persfi/riscv-snn-accelerator/docs/LOG.md

# Engineering Log

## 2026-07-03
- Finished verilog essentials over the last week on HDLbits. (modules, gates, ffs & latches, ALUs, counters, shift registers)

## 2026-07-04
- Ordered Arty A7 100T (digikey tw). See D1 in DESIGN.md.
- Installed verilator, GTKwave (from apt not source / see D2 DESIGN.md), make, venv for snntorch, numpy, pytest, torch that'll be used later. Did not use Conda for managing packages as it only tracks Python packages, so it's unable to track verilator or toolchains etc that'll be needed in the project.
- cd to root of wsl from powershell can reset ubuntu's password directly (bypassing wsl).
- Editors track venv by the name .venv so named it .venv instead of any other names.
- Learned makefile basics. ( $(path shortcut) / .PHONY tells make that they are commands not files )
- tool_versions.md for all tool versions including and outside venv.
- Ubuntu apt update failed due to connection issue with ipv6 (new type of ip address), switched to ipv4 → works
- requirements.txt created with make freeze so python packages can be installed in the future in one command.
- pip install torch installs the whole stack including ones designated for gpus (which i don't have), uninstalled and installed --index-url .../whl/cpu saving space. 
- project originally created in mnt/c, figured operating it from wsl slows it down, tried mv them to wsl home. mv failed, files got deleted before git init → had to reinitialize the whole project (always git init first)

## 2026-07-05
- installed vivado 2026.1 version (needed for arty a7 100t see D1 DESIGN.md): stripped bare except for arty A7 and basic tools to save disk space. 2026 july version's license had an update → used basic tier node locked (tie to machine)
- dll error when launching vivado, installed visual c++ distributable for the missing 2015-2022 x64 thats causing the error → works.
- ethernet MAC for vivado host ID (don't have dongle flexid of enterprises, disk serial number more fragile to drive swaps)
- Vivado installed on windows as wsl doesnt have default usb port that'll be used for connecting my board.
- learn riscv assembly → till stacks.

## 2026-07-06
- installed 64 riscv toolchain from apt, quick and can still run 32 compile commands.
- smoke test with c file passed → toolchain works properly.
- studied RISC-V isa, RISC-V assembly, single cycle datapaths, control unit mapping table, and performance eval → can start writing rv32i's verilog tomorrow.
- add riscv tests as git submodule for testing later.

## 2026-07-07
- \+ verilog (&sv) extension in vscode.
- some datapath labels dont follow riscv naming → switched all of them to riscv to make it easier to cross check with encode/decode tables.
- write data with clk, read data continuosly so that instructions can be proccessed in a single cycle.
- ascending index range is the convention for arrays ex [0:31].
- wrote regfile.v (combinational read, x0 gated both sides, no reset)
- theres 32 registers bc in isa they define 5 bits for rs1 and rs2. 
- need to map truth tables for ALUs design from isa spec.
- added make lint → checked for errors for regfile → all fine
- enable inset final newline in vscode to prevent lint warnings of their absence
- harness written by claude, reviewed the functions → understood what each of them does so i can write tests properly(generate boilerplate but unit tests are mine to write)

## 2026-07-08
- in simulator testing, if assign an value, it does not update automatically like real silicons do(for continuous assignments). Have to call eval() to tell the simulatro to reevaluate (see regfile_tb.cpp).
- only the signals that appear in the port list get exposed as accessible fields on the generated Vregfile C++ class so internally declared signals cant be called with dut.
- call tb defined methods with tb and verilator defined objects with dut (tb.top)
- tried writing to rs1_data and check if it is correct after settle(), failed tests. Figured reason: I can only drive module input ports in test files. anything written to output ports will get discarded after eval().
- may be able to recieve the fpga board on 7/10
- regfile_tb 8/8 tests success. (vscode underlines import as errors because verilated.h is in /usr/share/verilator/include/verilated.h not in project repo. The file is included from makefile so there's actually no errors. → add the path to c_cpp_properties.json to remove the false red underline)
- use 4 bits for determining the type of operations in ALUs because rv32i uses funct3 (8 variations) and funct7[5] (1 bit, 2 variations) to set them apart. 8 < 10 variations <16(4bit) therefore uses 4 bits.
- weighed localparam or 'define for my constants file(defs.vh). Chose localparam because it's actually a constant while 'define is just a macro replacing texts(hard to debug if its duplicated, no type support and lint will not catch the error).
- built alu.v ran lint, failed → RTL_SOURCES only includes (.v) → added Irtl/core to search through core → lint suceeded

## 2026-07-09
- wrote alu_tb, all tests passed (29/29). As alu doesn't have clk, added a no-clk condition in tb_harness.
- because there's a vh file for alu in core, changed unit-test call to make sure it searches for vh's when they're encountered
- wrote vectors.s, got to actually memorize the commands and sytnaxs from building not reading (failed to assemble when I didn't put commas between operands and mixed in several '//'s)
- assmebly: label is just the name for the addr of the next instruction
- CC enforces testbench split settings in claude.md thats based on file type rather than actually test logic → amended claude.md
- lint warns unused bits for inst → not sure if I won't use those bits in the future → added local lint waiver at port → lint pass. Same for vh file, as alu params arent used → local waiver at include → lint pass. 
- imm_gen tb passed (14/14)

## 2026-07-10
- wrote pc rtl lint and tests (6/6) passed.
- wrote imem rtl lint and tests (6/6) passed.
- parameter N = \$clog2(DEPTH) in imem.v, $clog2 might be risky for quartus versions but it should be fine with vivado for now. change in the future if needed.
- $readmemh, default verilog system task, copies hex text file to memory array. 
- program.hex will need to load too many tests, and if harness fails to copy then it will be a hard to catch bug → considered plusarg but it only works for sim to read at runtime and not for synthesizers (no runtime concept) → used a pragma of verilator, created load hex in harness to handle write to mem for all sim tests, synth is unaffected as the pragma would be seen as comment and it will run instead.
- typhoon today, board not arriving. 
- no need for 0x in hex files. 
- no need to write assembly instructions for imem testing because it doesn't matter if the hex encoded from the instructions are correct, the function I'm testing for imem is if it reads hex file properly and truncates the index of addresses correctly.

## 2026-07-11
- harvard architecture: needed seperate imem and dmem. Built dmem without write, test (6/6) passed. finish all leaf files.
- error in assign in core file, then realized its not actually a problen with assign its forgetting to write the module name → always debug from the first occuring error.
- output signals can be read in modules→ never seen in hdlbits practice but apparently its common. 
- wrote core rtl for pc+imem wiring, testing passed (8/8).
- error when linked all leaf files in core, turns out its because of defs's define guard, when multiple modules that uses it are loaded into core, the preprocessing state of verilator remembers that macro was called before so it doesn't load again into the other leaf files. but each modules has their own scope and needs to include param independantly → remove the guard 
- define guard was C convention, to prevent duplicating parameters in the same translation unit(complete chunk of C or C++ code that the compiler processes in one compilation) if included twice. but modules have their own scope so it doesnt apply to verilog
- wrote lw path, lint and test (25/25 in total for core) passed.

## 2026-07-12
- wrote sw path, lint and test (31/31 in total for core) passed.
- don't put spaces around trace "=" or itll return a empty variable error
- upgraded harness and trace handling (via claude as it's more of a boilerplate) to make tb visualization cleaner and saves time writing tb. 
- r type path wires, lint and test (36/36 in total for core) passed.
- riscv64-unknown-elf-gcc only accepted 0-31 shamt, tried -4 but failed → changed to 4
- last rtype test left pc at 24, need a rst or it reads old instructions.
- wrote itype paths, lint and test (43/43 in total for core) passed.

## 2026-07-13
- fpga board arrived, connected via micro usb. power led fine, done led works, preprogramed led patterns work. Vivado device manager can also connect to it, it also shows up on my windows device manager as a usb com port → basic tests done.
- decided to add seperate branch comparator, would use a bit more LUTs but it reduces the chance of errors from merging them into other units like alus. 
- bne x1,x2,4 doesn't work because i dont have linker yet, which is supposed to calculate the relative offest and plug into placeholder after assembling into object file. switched the raw numbers to labels intead, which the assembler knows thier position.
- wrote branch leaf file and test passed (15/15). didn't test it with core because by testing it individually first the core testing have much less variables to consider.
- wired btype datapath and passed test (59/59 in total for core)

## 2026-07-14
- added jal type and test passed (69/69 in total for core)
- added a jump > 4096 decoding imm in imm_gen to see that it does work properly for j far jumps. as the imem depth is set to 1024(for now) in rtl, can't test it in core without changing the setting, so testing it seperately in imm_gen is faster → (16/16) passed
- .org is absolute address, not offset, so I'd have to subtract the address of jal its jumping from to make sure its > 2048 (>512 index so that it uses the leftmost bit)
- confused jalr type instruction with jal and branches. rs1+imm jumps to absolute addr not relative to current pc → change the imms → jumps to the correct location.
- wrote jalr datapath and passed test (76/76 in total for core)
- lui unknown op was tested 3 times in the past already, skipped for jalr.

## 2026-07-15
- commeted out old lui tests bc now I've implemented lui it wouldn't work anymore
- added lui datapath and test passed  (78/78 in total for core)
- added auipc datapath and test passed (84/84 in total for core)
- figured in rv32ui test (ma_data) includes misaligned load and store. currently my project does not include misaligned address handling. In order to pass the test i have to do hardware misalign handling (doensn't fully support traps: no skip handler) → Decided to exclude it for now to prioritize the accelerator and the scheduler as that is the main goal of the project and misaligned address shouldn't be an issue for the project either.
- wrote load_ext and unit test passed (22/22)
- wrote loads datapath and test passed (92/92 in total for core) (nearly forgot the negative imm test). 

## 2026-07-16
- added store type datapath and test passed (98/98 in total for core).

## 2026-07-17
- learn more about linker concepts and how it organizes sections in tests (my tb didnt use it in previous tests because its just one .text file) → not going to use riscv tests linker because it starts with spike's(a riscv simulator) address base. using my own riscv test.h because theirs involve M-privilege mode's csr instructions. My core is a simple bare metal with no previledge setup, as my accelerator does not need any of them.
- using my own custum loading but the test vectors are tohost pass/fail check are still riscv's.
- generated linker and harness and passed all riscv tests(rv32ui) excluding ma_data and fence_i. 40/40 paseed, 2 excluded.
- vscode autoformats the .h as c and deletes the blank space between .section .text.init; use clang format off/on guard to prevent it happening again. 
- needs to prove the tst does report FAIL back tmrw by deliberately creating some errors in the rtl.

## 2026-07-18
- did negative test, changed add → all failed (everything uses add including env boot). cjanged or and xor → only their own tests failed → proved that the test reflects correct pass/fail.
- updated d4,d5 in DESIGN.md

## 2026-07-19
- added design decisions made during the building of rtl (D6, D7, D8).
- added riscv test results in DESIGN.md.
- learned about ctr0

## 2026-07-20
- updated riscv test results in DESIGN.md.
- seperated dmem from core so that soc can control and connect to accerator in the future.
- print and exit are not part of dmem and dmem and imem are different memory that BOTH have everything the linker defines.
- print only prints 1 byte.

## 2026-07-21
- updates soc harness via CC (infrastructure)
- wrote harness_test.S to test print and exit, both works.
- caps S so I can use define/include/any thing that needs to run with preprocessor
- li loads 32 bit immediate (lui+addi) 
- added crt0 and linker. inf loop in asm can be written as 1: j 1b (jump backwards to label 1)

## 2026-07-22
- x1 is ra that ret jumps back to, shouldn't be used to save other values in the assembly.
- la = load address = auipc + addi. sometimes the linker collapes 2 instruction from a pseudo instruction to one(linker relaxation). ex, only loading 12 bits is enough
- assemblers current section default to .text, since text init is declare in crt0, crt0 is placed in section .text.init
- tested hello.c and computation.c, hello prints hello world (71cycles), computation.c computes dot product of arrray (185cycles). switched * to + in computation.c cycles decrease to 73 (185-73=112; 112/5=22.4), around +23 for multiplication (as my core is rv32i not rv32im theres no dedicated multiplier so it uses a combination of current instructions)(calls to __mulsi3, a software routine in libgcc)
- avergae latency for multiplication is 22.4 but it is data dependant so each multiplication costs different cycles
- added assert at _end to make sure the theres at least 256 bytes between the end and stack top. 
- switched the stack top linker file order to the bottom, to prevent future confusion of the fact that it is higher than _end.

## 2026-07-23
- go through snn torch tutorials.
- snn neurons pass down either spike or non-spike, spike = 1*weight = w, non-spike = 0, no multiplication needed
- snn data is the most well documented and tested mnist, its 28x28=784 pixels, each has a probability of spike event depending on its pixel values. per event cost is fixed → is the next layer has 128 neurons, it will do 128 accumulative additions to the membrance of each neuron (1*weight = wight. where theres 128 weights). 

## 2026-07-24
- post training quantization for trained weights in software before loading them into mem bc it doesn't take floats.
- wrote lif (leaky integrate and fire) specs, pre designed number of bits of each symbols
- soft reset for exceeding threshold, decision docs in lif spec, which will be integrated into design md soon.
- leak constant beta will be done with V -= V>>k, which can be done without multipliers and as beta is a hyperparameter it is free to set. 
- if accumalation still exceeds 16bits after subtracting soft reset, clamp it within 16bits. safety net for overflow that might result in sign flips, but if clamping occurs too often or it visibly affects model accuracy, i should change weight scaling and make it smaller.
- leak (decay) with old membrane first before accumulation then threshold detection.
- spike encoding decision.
- before running accelerator, total cycle count should be predictable (predictable after ptq, encoding, and scheduler toolchain).

## 2026-07-25
- did lif_probe to check snn runs the steps as it says in its docs, leak>accumulate>fire, and checked that reset delay false does perform the reset immediately in the same timestep → all test passed
- chose immediate reset timing → no real benefit for delay which needs to forward another bit for previous state
- decided qat over ptq. qat trains what the hardware deploys and has better accuracy with slightly more complicated software (STE)
- installed torchvision for handling mnist and matplotlib for loss epoch graphing later.
- accidentally deleted a line of the snntorch library while reading it → fixed it. remember not to edit packages.
- no bias for the linear model because theres no continuous current that needs to be added in the lif equation

## 2026-07-26
- the forward of ste and forward of ratesnn is different. the ste one does the integer rounding while the ratesnn forward is the actual one that defines forward pass between all layers
- trained snn, 0.9762 test accuracy for k=2
- init_leaky is deprecated → replaced by reset_mem
- reset_mem resets the membrane per sample; each sample within a batch is trained in parallel with the others; samples are trained from T:0-20 before moving on to the next batch.
- done snn training apart from k sweep to choose the one with the best accuracy performance

## 2026-07-27
- loop through k from 1-5, chose k=2 for the leak beta because it has the second higher val accuracy compared to k=4 but way more stable that k=4 over epochs. although the differences in accuracy between the k varies very little so its not an important decision
- created golden model (rate_code, lif, and golden)
- used rng with seed for spike encoding, but realized that it differs if the batch differs, because it goes through every image per timestep before moving on to the next timestep, so if batch size increases, it will go through extra images (pixels) and the order of the generation will differ → switched to Thomas Wang's 32-bit integer hash generation method. because u is uniformly distributed from 0 to 255, the condition u < pixel creates a Bernoulli spike with probability pixel / 256 → (seed, image, timestep, pixel) ensures every pixel produced the same u
- batch doesnt matter in golden bc its pure inference
- decided that encoding and first quueuing of spikes should be done by c in core, or else its a whole new chunk of rtl. if there's time after completion, i can build it on the accelerator.
- the accel is a fsm and the core should only boot it and read its result
- exported golden model vectors for accel check in the future.
- check golden model against training snn and verified that the accuracy does not much with minor differences in weights, threholds, leak etc (that comes from converting float to int system)

## 2026-07-28
- studying possible accelerator design, figured that the counts.hex was in 32 bits, while the max count for each image is only 20(0or1 per timestep) → change to 8 bits

## 2026-07-29
- weight takes 1\*(784\*128+128*10) =101632bytes, 101632\*8/64=12704 lutram. only slicem luts can be used as lutram, which allows combianational read values from address. The utilization of lutram can only be seen during synthesis of the fpga, but since its a rather large amount of lutrams, directing it to bram would be safer, in case it doesnt work during synthesis. bram can only do synchronous read, so every read needs 1 clk cycle.
- decided to put the 128/10 v_i[t] (membrane) and acc in register. arty a7 100t has 126800 flipflops, accumulation needs 128\*32 while membrance needs 128\*16, core uses 32\*32 → 7168 in total, thats only 5.7%
- decided to load 1 word(4weights) of weights from bram every cycle, so if acc and v is in bram too itll need 3 more cycles to complete the read and perform combinational add with the weights → register allows combinational read → solves problem.
- ev_idx should be stored as lutram so it could be read combinationally. its not a register bc reg are independant ev_idx
- drew acellrator drain logic datapath

## 2026-07-30
- finish datapath design apart from sequenecer because it connects to too many things on the datapath and drawing it would just make the graph more difficult to interpret visually.
- leak and fire combines in lif unit. doesnt actually need to leak then drain then fire in hardware path, as long as the leak and fire's required data(v, acc) doesnt get over written it can be put together.
- acc_mem = reg / weight_mem = bram / v_mem = reg / ev_mem = lutram / spk1 = lutram
- sweep and drain all process 4 neurons at once (takes 1 word from address)
- spike push: 4 lanes can fire in one cycle but spk1 takes one index/cycle. loop i
over pending[3:0], stall_en holds word_cnt counters to prevent it from overwriting v. worst case is 5 cycles/group which is highly unlikely (4 consecutive fires)
- acc_mem is shared between layer1 and layer2, vmem cant becasue vmem persists through timesteps so theres v1,v2
- ev_mem gets 2 banks so host fills B while accel drains A -> so that accel doesnt have to wait for host to fill from t=1-19
- weight address is {idx, word_cnt}, a concatenation, not i*32+j — works because 32 is <<5 and word_cnt = [4:0]. by concatenating them its equivalent to shift idx <<5 and + cnt
- sequencer state is 2 orthogonal bits: layer_state (0=L1) and act_state (0=drain),plus outer states for idle/wait/done.
- accel keeps its own t because its gap between core t varies from 1 to 2
- spk1_wr_ptr also serves as spk1_len bc after existing the push to queue nothign updates it and it holds spk1_len.
- add mmio ports for accel
-  the host only encodes and fills the ev mem whenever theres space: its t has no relation to what stage the accel is at

## 2026-07-31
- changed mmio. ev and weight should be passed to accel by mmio and accel stores it in its mem array (which are lutram and bram respectively). 
- uses BASE + 4u*(i) so each word has its own addr, and that addr decodes into the idx of the mem array. the addr doesnt hold anything, only the array does.
- chose that over an auto-increment port (one fixed addr + ptr) bc direct addressing is readable to host, accel would also be free of the ptr reg.
- updated design decisions notes thatll be written to design md soon

## 2026-08-01
- accel should be able to process models with a different hdden layer configuration (diff number of neurons). added accel_l1_shift to mmio, shift is for the weight addr decoding so accel doesnt have to do it by itself. shift 
- _stack_top is actually just outside dmem and imem.
- design md memory maps and host accel interface table and use sequences.

## 2026-08-02
- wrote weight memory rtl for accelerator.
- read data should also be <= non blocking as its bram so theres a read delay. And it should not be in a condition check because the mem should read no matter if its write or drain state, only the acc mem chooses not to udpate.
- added accel scripts to lint harness.
- w_mem_tb test 8/8 passed; weight_mem_tb test 5/5 passed.
- forgot to check the read via layer_state, added it using read_at function to prove that the state select works.

## 2026-08-03
- wrote lif_unit rtl lint passed and test 19/19 passed.
- forgot to check the v_th and k assignments that prove that they aren't hardcoded → added them → test passed
- need another top module like the w_mem and weightmeme herirachy to control the layers state for lif_unit (k and v_th differs), also to control the stall and write spike to queue logic.
- negative arithmetic shifts round away from zero when there is a remainder.
- need to put $signed around part select v/acc and sign extended v/acc
- my 'for' is procedural (uses = for combinational reads) in lif_unit so it needs to be inside 'always'.
- moved DESIGN.md to root for visibility.

## 2026-08-04
- wrote counter lint and test 8/8 passed.
- counter should be like w_mem, with a top module instantaniate diff counts.
- mem in acc_mem is an unpacked array, can't part select across words → change it into a loop inside always → lint clean
- wrote acc_mem lint and test 11/11 passed.
- folded we and clear into a 2 bit ctrl so both cant be high at once
- wrote acc_rdata[i+:32] instead of [i*32+:32] , resulting in it reading overlapping bits → caught the bug and fixed it
- at first I wrote clear as 'else' after write, causing mem to clear whenever it's not writing. Might be harmless but more likely a bug in the future when theres cycles in drain thats not writing. → changed it to the 2 bit ctrl for safety.

## 2026-08-05
- wrote v_mem lint and test 15/15 passed
- combined v1 and v2 mem as it's small enough and when sequencer orders clean it should clean both at once, combining them simplifies the rtl.
- word_cnt needs to cap to 2 for the output layer (10 neurons, pad to 12, thats 3 words so 0,1,2 for word_cnt)
- originally used 8 bit for base but the lanes*word_cnt is 32 bits which caused an error → widen base to 32 bits → fixed the error

## 2026-08-06
- wrote spk1.v lint and test 6/6 passed.
- the sequencer handles wr_ptr (wr_addr)=0 and end which is spklen, and we comes from lif sweep push logic. spk1 is a reg mem array and takes 1 index per cycle so thats a 7 bits input wr_data. rd_addr never read and write at the same time so it'll be reuse (addr) with wr_addr: sequencer decides what state its at 
- wrote ev_mem.v lint and test 8/8 passed.
- needs both wr and rd addr because they happen at the same time and points to different boxes. we also exist as not all core outputs that lands in ev mem address region are writes
- 0xaaaaaaaa is unsigned bc hex literal gets fit into int then unsigned int, 0xaaaaaaaa is beyond int so it becomes unsigned, which is why a cast to signed is needed.
- wrote drain.v lint and test 4/4 passed
- drain is pure alu, the addr generation and delay logic should be managed by sequencer.

## 2026-08-07
- changed export_vectors to emit weights that'll be loaded into accel (8bit and flat) → emitted the new w1 & w2 hex. 

## 2026-08-09
- need an mmio module to input data from core to accel. Accel needs to know which bus to write to and that addr is inputted in mmio module by core_d_addr, core_wdata for the value to write to accel, and core_d_rdata for accel output
- host_addr in accel_mmio is 8 bits as in mmio.h the accel related parameter addr were already decided with offset from 0x10-0x40+36(count queue), thats 0x64, which is representable within 7 bits (takes 8 just for convention)

## 2026-08-10
- wrote addr_gen lint and test 4/4 passed.
- hidden state variation should be done later as a refractor after the sequencer and accel.v are succesfully wired
- added word_cnt_q to acc mem because acc writes one cycle later than its read (which is used for v calc), and it's way simpler to create another port than to use flags
- added state_q so the delay in acc can be seperated from v without needed flags.
- redo acc mem tb 14/14 passed.
- sequenser layer 1 fsm complete: drain/sweep loop, rd bank = t[0]. sequencer tb tomorrow to check the timing bugs of today.

## 2026-08-11
- found a critical bug after tb: adding a delayed word cnt for acc mem doesnt work. bc after reset, cyc0 holds weight addr, cyc 1 reads the weights (bc bram needs cyc to read) and acc adds combinationally, then write at cyc 2 (write lands, write on edge). but acc read uses wordcnt which is now [4-7], and by cyc two write, its writing to [4-7] not the correct [0-3]. 
- out of several options i can think of: 1. add a new state 2. delay v and acc 2 write 2 cycs 3. add a prime cyc that reads the first weight before cyc0 → speeding weight read 1 cyc. The third is the cleanest bc nothing else needs to change only need to add prime before every timestep or right after rst. 
- since counter starts from 0 from prime, the acc read and write are now both delayed on cyc. Only need to pass word_cnt_q to acc mem now.
- added ev_idx_q bc ev_idx is passed to addr gen to read the weight, which is also one cyc earlier, by the time its 31, the weights only arrives a cyc later. acc and v ctrl are combinational if state changes the next cyc, they will clear/idle, so that the last [31] acc/v wouldnt be written → state change depends on ev_idx_q
- sequencer.v layer one lint and test 30/30 passed.      
-  wired up accel.v to test layer one's sequence against golden model
- first run failed → layer state used state[0] which turns to 1 when state==1 (sweep of layer one), so that v mem took layer 2's arrays to write to (layer_state 1 = layer 2). layer 1's vmem was untouched → return 0. 256 tests only passed 128 (acc checks are correct). 
Changed layer_state decoding in sequencer → accel layer 1 test passed 256/256.
- In accel.v , as accel_mmio.v isnt wired yet, pass the params from accel's input ports so tb can drive them directly.
- added linf off ununsedloop in vmem bc the clear loop hasnt been driven yet. will be driven after the clear state is added in sequencer.

## 2026-08-13
- added clear v and clear acc in prime state so that after the start of every image, the v and acc gets cleaned properly.
- acc clear is per group during sweeps so added another acc clear all to clear the whole mem in one cyc.
- changed old tests in sequencer tb and removed the manual zeroing in accel tb → 30/30 test passed & 256/256 test passed. 
- wired ev bank selection, found a bug : while switching timesteps (and ev banks), the timestep switch is based on t_stall, but t_stall is controlled with word_cnt_q. so in the last cyc, the weight read the previous bank (addr gen of weight uses ev_idx)'s idx's weights → changed the t_stall read to word_cnt
- re-test sequencer and accel for bank switches → 31/31 tests passed & 512/512 test passed
- 3 hrs trying to write the pending logic without a table  → failed. ALWAYS have a TABLE first for sequencial planning!
- old states dont work → the sweep introduces pending queue logic and without another state it cannot hold the correct word_cnt from sweep -> drain. such that drain cannot read the correct weight[0] in the first cycle. → seperated clear and prime into clear prime0 and prime1. clear per image start, prime between clear and drain0 and between sweep0 and drain1.
- the prime now means to clear word counter to hold it at 0 and both v/acc should be idle. This allows the weight[0] pre-read and processing remaining pending spikes after sweep exited.
- spk1_wr_ptr need a mux with ev_idx[6:0] to generate the correct addr for spk1 because spk1_wr_ptr is also used to identify ev_len for layer 2, and ev_idx is for addrgen of layers 2 weights during drain1.
- tested the spike input of sequencer to addr and spk wr data output through sequencer tb against first image(20/20 timesteps) of golden model. 1113/1113 tests passed.
- spike groups in the first image inclues 0-4 neurons spiking on the same time → verifies that the pending and queuing logic is correct and robust.
- update accel tb to test from image start to end of layer 2 sweep (before writing to the 10 counters) against golden model. tests 297/297 passed.
- had to poke vth through tb → figured the mux for vth selection isnt wired in accel yet → updated it.

## 2026-08-14
- instance outputs are connected to wires. if connected with reg it means that you intend to drive it in the parent module. so even if the output from the module is a reg it shouldconnect to a wire. 
- wrote count.v lint and test 22/22 passed.
- linked count and accel_mmio to accel.v. replaced the tb poking config in accel tb cpp and changed it to the accel_mmio path → check that it works and the hostwe and mmio select is correct
- caught a sweep1 bug: if only the last group spikes, wr ptr would be 0 when its entering the prime1. so then it will automatically trigger sweep1 start from the original wiring in sequencer, skipping drain1.  → added pending ==0 which is also the exit condition of prime1. only when prime1 is exiting does it prove wrptr=0 actually means there are no spikes.
- imgdone bug : wrote t==t_max but it should be t==t_mx-1.
- sweep0 exit bug during accel 20 timesteps test: original exit condition is if state = sweep0 and wordcntq=limit, but if theres a pending spike on group30, wordcntq still advances to 31 before stalling, so the conditions would be met and state advaces to prime1, locking v and acc so that the lif of word_cnt_q=31 never writes back → added && pending==0 condition that make sure wordcntq =31 is considered before beiing skipped.
- tested sequencer tb with updated rst start path, 1113/1113 tests passed
- created accel tb over all 20timesteps of all 10 images against golden model. lint and test 60861/60861 passed

## 2026-08-15
- update DESIGN.md. Gradually fill in the design essentials.
- edited mmio count so that the core can au=ctually get the per byte: accel count w(0) is the raw 32 bit word while accel count(0)is the actual value of that neuron

## 2026-08-17
- connected accel and core with soc.
- accel output accel rdata, cannt wire the port to host rdataa or else the mux and the accel will both be driving host rdata, causing lint errors (the first driver will be used, which is the mux). → fixed, lint passed

## 2026-08-18
- added image encoding in c in libsnn. #include "" search in own directory while <> searches system include directories in usr/indlude or -I flags 
- wang32 is ibjective thats what makes it uniform.
- simplified make commands and added print int mmio so that integers can be passed without needed to convert to char or pass twice. 
- emitted images.hex from export vectors to generate image.h
- makefile/hex to c script generated via cc (infrastructure)
- edited makefile and checked image0's per timestep spike counts via mmio_print_int against the golden models ev_len(first 20)
- added readmemh to weight mem so that it reads weights before boot. saving 2/3 space from loading into expanded imem and dmem

## 2026-08-19
- added a bank_ready signal bc i realized host needs to write bank when bank free but accel drains when bank ready. if host is still writing accel shouldn't drain.
- host writes way slower than accel so the bank ready is necessary (even for safety it should still exist)
- in tb event data was directly written to bank without checking any free signals and without encoding its way faster than accel so no problem ever occured then.
- volatile stops the compiler from moving things around and messing up the hardware sequence

## 2026-08-20
-soc runner cyc limit was capped at 200000 which wasnt enough for one image inference → prints error msg → increased the cap to 3000000.
- wrote the c driver and updated makefile to test the whole system(test-system) including the c driver.
- test system failed → figured that the new bank_ready means the accel will wait at prime0 and start draining until bank_ready==1, and word_cnt runs continuously so word_cnt_q loops with it as well. After bank_ready, the word_cnt_q very likely would not be 0 anymore, so that acc saves to the wrong memory.
-tb passes because it's write to bank uses event idxes directly from golden vectors so that theres no encoding cycles, making it way quicker than the accelerator → the accelerator never tested bank_ready=0 + prime0 becuase bank_ready was always ==1 in tb

## 2026-08-21
- added a word_cnt stall in sequencer to prime0 before bank_ready → system-test 10/10 (each image's final prediction + spike counts for each class) passed
- changed word cnt stall instead of clr because clr is non blocking so when bank is ready, it will zero the conuter by the first cycle of drain, but word_cnt should be 1 and not 0 at that time(it needs to gen addr for weight read).

## 2026-08-25
- added the shift register so the model can be built with 32/64/128 neurons for the hidden layer
- it cannot take 60 because the ev_rd_data shift for weight addr gen is a power of 2. 60's shift value is still 4, which still does ev_rd_data*16 and not *15. It will only work if the weight hex is padded with 0 to 16 per row, which is unecessary since I only wanted to validate that more than 1 hidden size works.
- lint and unit test/system tests still passes after adding the shift register(and correcting the tbs).
-  (w1_we || w2_we) ? host_addr[16:2] is for the tb. actual fpga run uses readmemh.
- readmemh saves the space because if its loading after boot, the weights needs to be stored in core because it's not derived in core, it's a file from pc, so it takes up a way larger imem and dmem (more than the current size it's defined)
- accidentally passed string got w1_init and w2_init instead of macro. macro needs "`".  → changed it, error resolved.
- h64 accel test failed → foudn that ive been passing h128 thresholds as acc matches perfectly but v came out 14 lower (which is the threshold diff). → added a find key from manifest json function so that it uses the values thats from the model thats currently being tested
- ran k=2 for hidden sizes of 64 and 32, exported their golden model, and validated that the accel does produce the correct result for different hidden sizes. → accel tb 33495/33495 passed for hidden=64 and 19331/19331 passed for hidden = 32
- changed accel tb such that the different weights could be loaded from bus without using readmemh and different thresholds come from manifest json instead of being hardcoded
- changed mnist.c so that there's no two T inputs one controlling the counter one controlling the bank selection from core as they should be the same → added a static int saved while config is called so snn run automatically gets the same T

## 2026-08-26
- added netcfg that's emited from snnc.py, which gathers the wanted parameters values from the run files. It should be run on pc before compiling app and core boot.
- added SHAPE to makefile to drive the correct network model in both the sw and the rtl.
- hidden 32/64/128, test system passed.
- make app doesnt regenerate netcfg, wired SHAPE to it → bug fixed

## 2026-08-27
- change the readmemh file in dmem so it loads the same hex as imem. added the macro so i can define the path outside verilog for vivado
- added accelerator decisions a1-a5 in DESIGN.md and updated memory map
- created acc, v and weights distribution in docs/img to visualize and verify that they do not exceed their boundaries. (across all three models max|acc| = 2,402, max|v| = 8,874, so 3.7× headroom in int16)
- trained deferred reset and got int accuracy of 0.9702 over the 0.9763 of immediate reset (float 0.9725 vs 0.9759, both from check_vs_float)
- check vs float emits whatever the config it is currently in model.py so make sure model.py contains the correct config

## 2026-08-28
- stderr fprintf is for msgs, warnings and diagnostics while printf is stdout.
- wrote accelerator decisions a6-a9 in DESIGN.md
- added sim prediction output and stall vs working cycle count in soc runner. working: 12.9% at h128, 6.5% at h64, 3.3% at h32 → drain and sweep shrinks for less hidden neurons but encoding cycles doesnt.

## 2026-08-29
- write results in DESIGN.md and generated bar graphs for visualization
- created mnist_core to run the inference purely on core to generate the exact cyc counts 
- mnist_core needs state markers so that it can output how many cycs were ran for encode and eval stages.
- updated the harness infra to run core only.
- weights for core run are loaded into dmem with a widening dmem. dmem widened from passing flags to verilator since its depth is reachable through soc. imem still passes program.hex only but the exit error is changed to warning if it overflows. (if it overflows data, imem is still safe bc it only read instructions, thats why changed to warning)
- linker_bench ld for moving stack top higher bc dmem expanded.
- originally the order of the loop in mnist core wasn't the exacpt same as accel, and it adds cycs. changed it so that the comparison is fair.

## 2026-08-30
- wrote section4 verification for accelerator in DESIGN.md
- s_in.hex was just exported along the others but its not used to verify or input anything so dropped it from the output
- added spk2 check in accel_tb. thats checked by the difference in coutns every timestep. all tests passed.
- test encode only ran one img at a time → added a loop to makefile to run all 10 imgs and compare against evidx and evlen instead of just evlen
- tbs were able to read rtl mems because of --trace. added  verilator public_flat_rd to all of the read mems in rtl
- changed makefile so now make check runs over all shapes instead of just h128.

## 2026-08-31
- write README.md

## 2026-09-01
- edit DESIGN.md README.md format and DESIGN.md 3.3 table/intro.

## 2026-09-08
- created project on vivado
- test blinking on fpga: run synthesis, implementation, generate bitstream
- declared a 100mhz clock and a led to see it blink
- the reset button of the arty is wired to dedicated pin program_b so it reconfigures the board when pressed. (_B is active low)

## 2026-09-13
- synthesized the project, found a bug in sequencer where layer state is assigned in always but not declared reg in output port(verilator allows it but vivado uses standard rules of verilog)
- address of the weights is 15 bits thats 32768 addresses. Each tile holds 1024 addresses. so w1 is 32(32768/1024) tiles * 1024\*36\(bits of each tile\) =144KB (vivado synthesized RAM36 which is 36 bits per tile to the w1 mem). In DESIGN.md memory map it's 128KB because 32768*32 = 128KB.
- pc(with imem) with report_utilization -hierarchical from tcl shows that the ram takes 1315 while dmem is only 550(lutram). thought that theres some issue with imem. but then after -flatten_hierarchy none, figured its 1315 because its the whole path including alu, branch, and other combinational modules. The actual lut used for imem is 289
- imem is 289 and dmem is 550 because dmem is actual lutram while imem is compressed into logic because it doesnt have write port. 
- vivado cant find the readmemh file because it doesnt run from this project dir root. Add_files to source(the three includes) and used verilog_define {PROGRAM="mnist.hex" W1_INIT="w1.hex" W2_INIT="w2.hex"}. Forgot to add "" and that the include doesn't treat it as string → added it. No more errors.
- changed xdc's original clk name to my clk pin name

## 2026-09-15
- ran implementation. WNS worst negative slack = -7.501, needs at least 10+7.501 ns between each cycle. 1/17.501 = 57MHz, so 50Mhz clock works with some slack
- added plle2_base module from example templates in vivado, edited it to make it output 50mhz
- implemented the pll to blink to test if it actully works. becasue the lock(meaning pll has settled to a stable output) is only high when pll has configured properly, so as it blinks properly after programming it to the board, it means pll is correct
- cant divide the outpput clk with DIVCLK_DIVIDE bc this output is VCO, and VCO has to be from typically 800MHz to 1600MHz on arty a7 so its later devided to 50MHz with CLKOUT0_DIVIDE instead
- accidentally checked "copy source to project" while adding the fpga directory → source not updating when theres changes in the repo bc it reads a copied version → delete and uncheck it

## 2026-09-16
- wired led sel to soc so the led_q can be connected to the top module (which it drives the actually leds in the xdc)
- mnist.c write the led index to mmio_led, which is a store instruction for it so core_we will be 1. mmio_led is write only now because I didnt add an arm of it to core_d_rdata (not needed in the c program)
- updated harness (makefile) to print the led in terminal
- wrote top.v with a 2 flop synchronizer for the reset function that delays the reset by two edges to prevent unstable signals.
- new wns with top added after synthesization and implementation : +0.308ns. critical path spends 80% in routing rather than logic
- red prog button is for loading the program from flash. I rpogrammed the board over jtag so theres nothing in flash
- set btn[0] for the reset button. 
- programming the board, succesfully inferred img 9 (the current img index generated)

## 2026-09-17
- increase imem and dmem so that it can fit 10 images' pixels → mnist hex's const array images will be compiled and places in .rodata(read only data) → so based on the switches on the fpga the program and tell which image I want to infer now → no need to re-synthesize and implement for every image
- git commit corrupted → deleted it and it's 18 0 byte objects and recovered the one before the last commit
- changed imem and dmem's tb array probes so that it depends on the array size and not hardcoded address
- added sw from xdc and to top.v. added the read mmio bus for sw number.
- WNS would likely be negative again since mapped more memory (longer traces between things) → -2.134ns → changed the clock to 40mhz → +0.508ns wns (not as much as the calculation bc Vivado will stop optimizaing once the constraint is met)
- changed mnist.c so that it reruns the program continuously. so if the switches change I dont need to press reset button to see the update.
- used ifdef such that sim still reads the non-looped version (tb has cycle limit) while vivado uses the looped version
- fpga works
                                               
## 2026-09-20
- record demo video
- add fpga results to README.md
- core's critical path is the load instruction that goes to imem regfile dmem then regfile writeback.
- to access lutram the signals fan out to couple thousand. if its in bram since bram is in blocks it'll only fan out to 4 blocks. So in terms of speed lutram is slower but it reads on the same cycle
- accelerator's critical path is 20.9ns which means ~48mhz ceiling for clock. to increase clk frequency i'd have to pipeline both the accel and the core or else if i only do the core the clock will cap at 48mhz. (Or I use different clocks for them but thats a future design decision)

## 2026-09-21
- drew accelerator datapath and add to README.md
- host decode is not a real module but one drawn to represent some combinational logic written loosely in accel.v
- draw io colors vanish (for lines). used dash to represent ctrl signals instead
- read mem addresses are still ctrl because they arent used as data to store

## 2026-09-22
- added FPGA timing and utilization to DESIGN.md §5, fixed memory map to 16KB
