persfi/riscv-snn-accelerator/docs/img/accel_dark.png

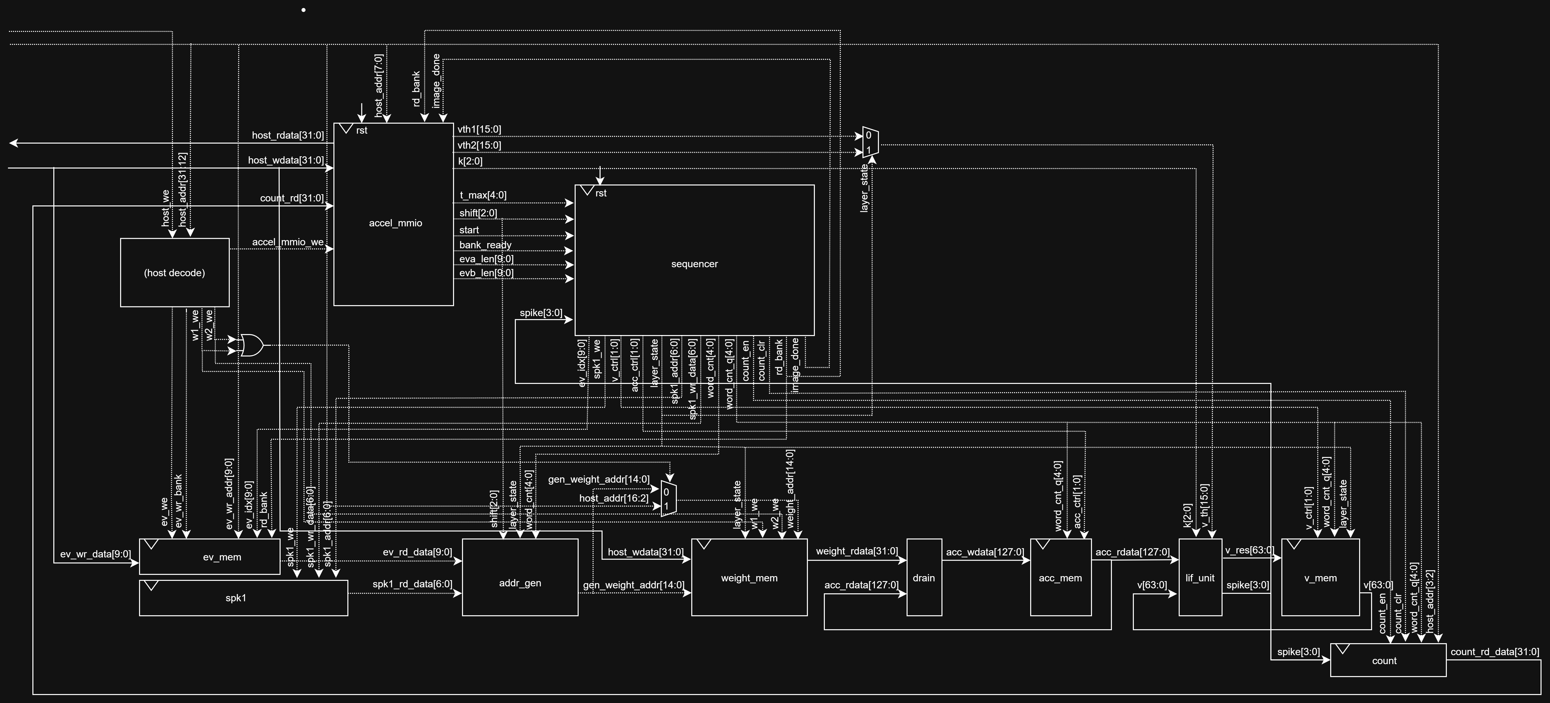
docs/img/accel_dark.png
