persfi/riscv-snn-accelerator/docs/img/dists_snn_h64_k2_T20.png

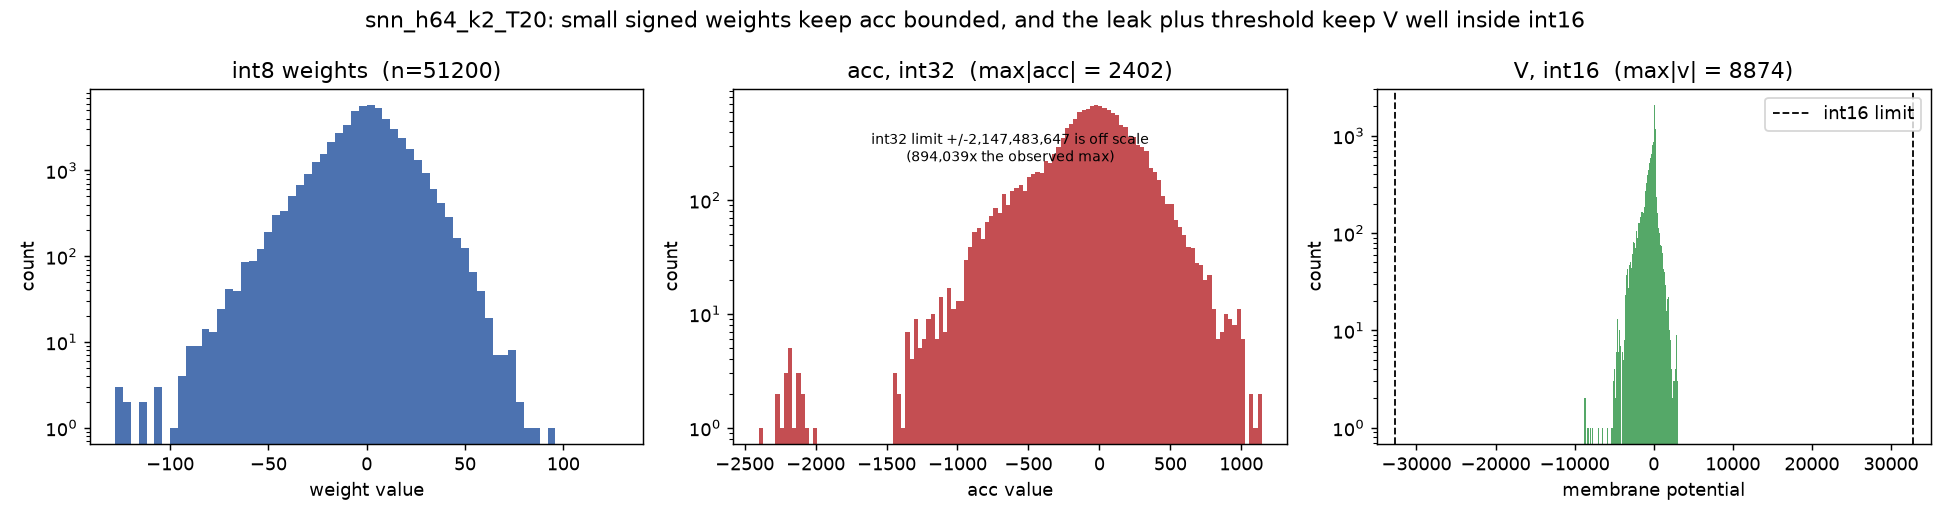
docs/img/dists_snn_h64_k2_T20.png
