persfi/riscv-snn-accelerator/fpga/arty-a7-100/blink.v

module blink (
    input wire clk,
    output reg led0_b,
    output wire led0_g
);

    reg [25:0] cnt;
    wire clk_sys;
    wire pll_locked;
    always @(posedge clk_sys) begin
        
        cnt <= cnt+1;
        led0_b<=cnt[25];

    end

    clk_gen clk_gen(
        .clk_in(clk),
        .rst_in(1'b0),
        .clk_out(clk_sys),
        .locked(pll_locked)
    );

    assign led0_g = pll_locked;


endmodule
