persfi/riscv-snn-accelerator/(commit log)

2026-07-09 feat(core): add immediate generator with assembler-derived tests
2026-07-11 feat(core): wire pc and imem into a top-level core module
2026-07-20 feat(soc): add soc top with dmem, address decode, and print/exit MMIO
2026-07-21 test(verif): add soc program runner + asm test for print/exit MMIO
2026-07-25 feat(model): add MNIST loader, rate encoder, and QAT weight quantization
2026-07-27 feat(model): add golden model, deterministic rate encoder, and RTL vector export
2026-08-11 refactor(accel): revert acc_mem address split
    [acc_mem.v]
2026-08-14 feat(accel): add output spike counters and wire the mmio register file
2026-08-14 fix(accel): hold sweep0 until pending drains so the last group writes back
    [sequencer.v]
2026-08-17 fix(sw): read packed count words through the mmio count accessor
    [mmio.h]
2026-08-18 feat(soc): wire the accelerator onto the core data bus
2026-08-19 feat(soc): add a word-wide print register for dumping values
2026-08-20 feat(accel): stall the drain until the host hands over a filled bank
    [accel.v, accel_mmio.v, sequencer.v, sequencer_tb.cpp]
2026-08-22 feat(sw): add the snn driver and mnist app
2026-08-22 fix(accel): hold the group counter while prime0 waits for the bank
    [sequencer.v]
2026-08-22 docs: correct the weight preload and add print_int to the memory map
2026-08-27 feat(tools): generate the driver's network config from the trained run
2026-08-29 feat(verif): report stall cycles and the prediction from the soc runner
2026-08-31 test(verif): compare encoder indices and run check over all shapes
2026-09-16 feat(rtl): add an LED register to the SoC
2026-09-17 feat(fpga): run the SoC on the Arty and show the prediction on the LEDs
2026-09-18 feat: select the demo image from the board switches at runtime
2026-09-18 fix(fpga): drop the system clock to 40 MHz to close timing
    [blink.v, clk_gen.v]
2026-09-18 feat(sw): rerun inference continuously so switch changes need no reset
2026-09-21 docs: add board demo video to README
